mcous/rgb/README.md

# rgb
rgb led lighting. modules are (read: will be) daisy-chainable over cat5/6 cabling.

## status
### what works now
* the leds
* a few effects
  * cylon eye
  * new orleans superdome-syle rainbow flow
  * maybe some others

### what doesn't yet
* all other features

## firmware
### requirements
#### software (for mac, just download [CrossPack for AVR](http://www.obdev.at/products/crosspack/index.html))
* avrdude
* avr-objcopy
* avr-objdump
* avr-size
* avr-gcc

#### equipment
* some sort of avr isp

#### avr libraries
* [this tlc5940 avr library](http://github.com/mcous/TLC5940)

### setup instructions
1. clone the rgb repository to wherever you'd like
2. clone the TLC590 repository to the same place (i.e. one level above rgb/)
3. edit rgb/firmware/Makefile to use your isp (default is adafruit's [USBtinyISP](http://learn.adafruit.com/usbtinyisp))
  * depending on your isp, you may need to add `-P /whatever/your/port/is` after the isp name
  * per usual, [ladyada](http://www.ladyada.net/learn/avr/avrdude.html) can help

### flashing instructions (mac or linux)
1. plug in your isp and adjust makefile's portif necessary
2. navigate your terminal to rgb/firmware/
3. first time flashing:
  1. `$ make test` (ensures avr and isp are working)
  2. fix any connectivity problems; this will range from unplugging your isp and plugging it back in to re-soldering your mcu
  3. `$ make fuse` (writes correct fuse values to the avr)
  4. `$ make test` (ensure the new fuse values match the desired ones)
4. `$ make clean`
5. `$ make flash`

### instructions (windows)
1. google

## hardware
### requirements
* [KiCad eda software suite](http://kicad-pcb.org)
* [these KiCad libraries](http://github.com/mcous/kicad-lib)

### instructions
1. open kicad
2. open rgb-pcb.pro
3. ensure all component and footprint libraries from mcous/kicad-lib are installed
4. generate gerbers
5. order pcbs from your favorite manufacturer and parts from your favorite distributor
6. don't breathe the solder fumes
