mcous/rgb/pcb/rgb-pcb.sch

## KiCad design pcb/rgb-pcb.sch (2013-05-14)

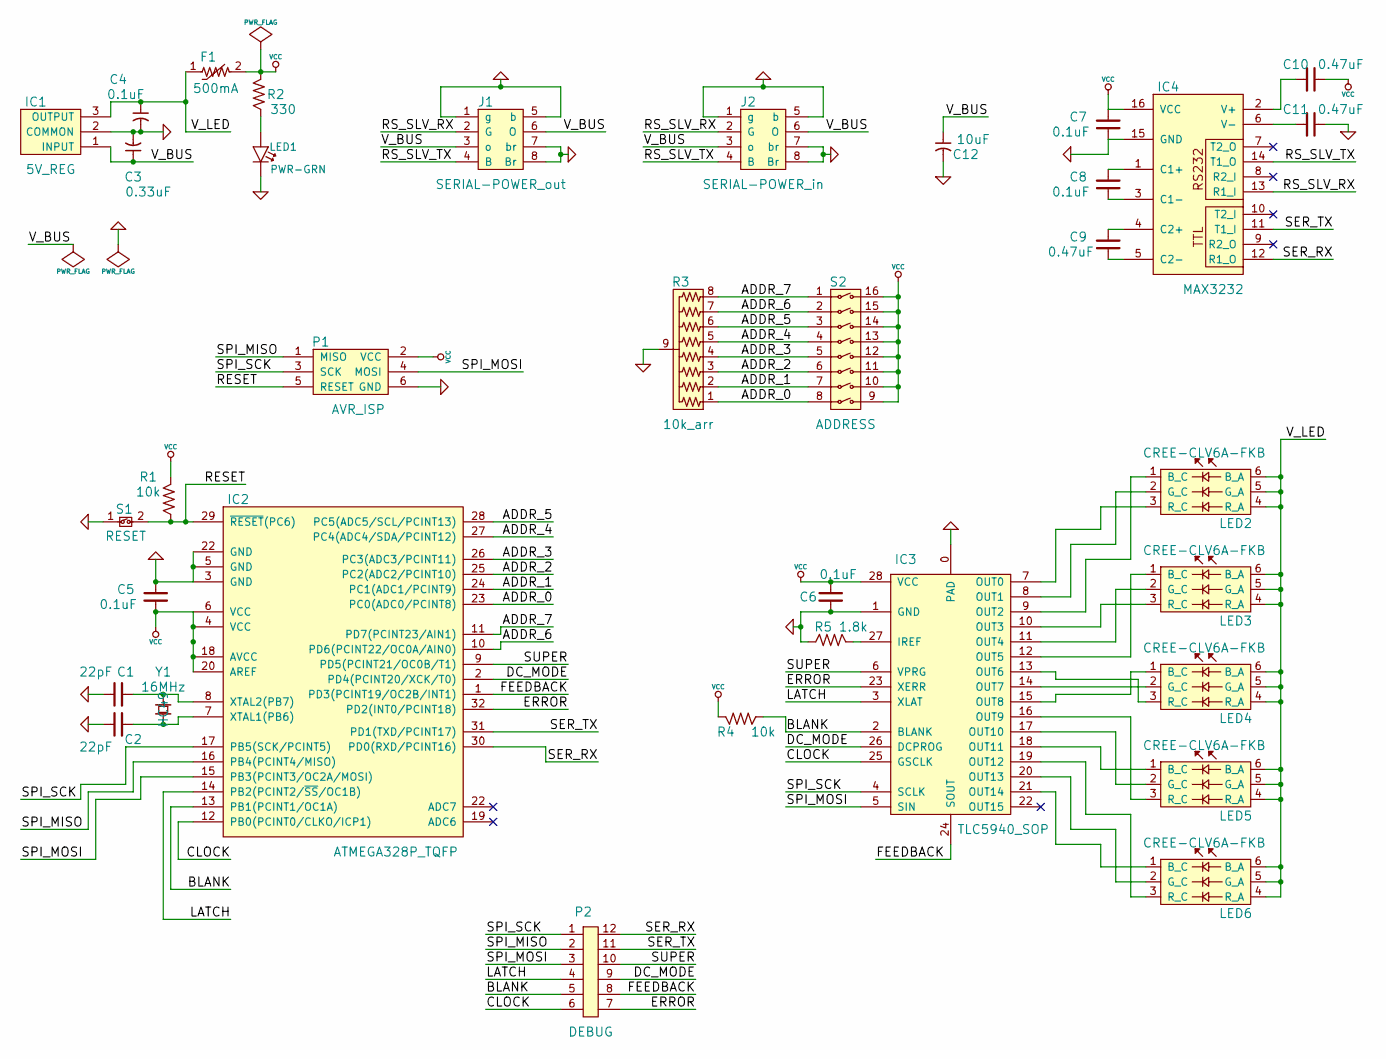
[picture p1: schematic rgb-pcb.sch]

Parts:
C1, C2: 22pF; 0603(1608m)
C3: 0.33uF; 0603(1608m)
C4, C5, C6, C7, C8: 0.1uF; 0603(1608m)
C9, C10, C11: 0.47uF; 0603(1608m)
C12: 10uF; 1206(3216m)
F1: 500mA; 1206(3216m)
IC1: 5V_REG; TO220_3pin
IC2: ATMEGA328P_TQFP; TQFP32_7mm
IC3: TLC5940_SOP; HTSSOP28
IC4: MAX3232; TSSOP16
J1: SERIAL-POWER_out; 8P8C_thru
J2: SERIAL-POWER_in; 8P8C_thru
LED1: PWR-GRN; 0603(1608m)
LED2, LED3, LED4, LED5, LED6: CREE-CLV6A-FKB; PLCC6
P1: AVR_ISP; 2x3-array
P2: DEBUG; SIP12
R1, R4: 10k; 0603(1608m)
R2: 330; 0603(1608m)
R3: 10k_arr; SIP9
R5: 1.8k; 0603(1608m)
S1: RESET; SPST_4-pin-thru
S2: ADDRESS; DIP16
Y1: 16MHz; HC49

Connections:
ADDR_0: IC2.23 (PC0(ADC0/PCINT8)), R3.1 (R1), S2.8
ADDR_1: IC2.24 (PC1(ADC1/PCINT9)), R3.2 (R2), S2.7
ADDR_2: IC2.25 (PC2(ADC2/PCINT10)), R3.3 (R3), S2.6
ADDR_3: IC2.26 (PC3(ADC3/PCINT11)), R3.4 (R4), S2.5
ADDR_4: IC2.27 (PC4(ADC4/SDA/PCINT12)), R3.5 (R5), S2.4
ADDR_5: IC2.28 (PC5(ADC5/SCL/PCINT13)), R3.6 (R6), S2.3
ADDR_6: IC2.10 (PD6(PCINT22/OC0A/AIN0)), R3.7 (R7), S2.2
ADDR_7: IC2.11 (PD7(PCINT23/AIN1)), R3.8 (R8), S2.1
BLANK: IC2.13 (PB1(PCINT1/OC1A)), IC3.2 (BLANK), P2.5, R4.1
CLOCK: IC2.12 (PB0(PCINT0/CLKO/ICP1)), IC3.25 (GSCLK), P2.6
DC_MODE: IC2.2 (PD4(PCINT20/XCK/T0)), IC3.26 (DCPROG), P2.9
ERROR: IC2.32 (PD2(INT0/PCINT18)), IC3.23 (XERR), P2.7
FEEDBACK: IC2.1 (PD3(PCINT19/OC2B/INT1)), IC3.24 (SOUT), P2.8
GND: C1.1, C2.1, C3.2, C4.2, C5.2, C6.2, C7.1, C11.2, C12.2, IC1.2 (COMMON), IC2.3 (GND), IC2.5 (GND), IC2.22 (ADC7), IC3.0 (PAD), IC3.1 (GND), IC4.15 (GND), J1.1 (g), J1.5 (b), J1.7 (br), J1.8 (Br), J2.1 (g), J2.5 (b), J2.7 (br), J2.8 (Br), LED1.2 (K), P1.6 (GND), R3.9 (COMMON), R5.1, S1.1
LATCH: IC2.14 (PB2(PCINT2/~SS~/OC1B)), IC3.3 (XLAT), P2.4
unnamed: C1.2, IC2.8 (XTAL2(PB7)), Y1.1
unnamed: C2.2, IC2.7 (XTAL1(PB6)), Y1.2
unnamed: C8.1, IC4.3 (C1-)
unnamed: C8.2, IC4.1 (C1+)
unnamed: C9.1, IC4.4 (C2+)
unnamed: C9.2, IC4.5 (C2-)
unnamed: C10.1, IC4.2 (V+)
unnamed: C11.1, IC4.6 (V-)
unnamed: IC3.7 (OUT0), LED2.3 (R_C)
unnamed: IC3.8 (OUT1), LED2.2 (G_C)
unnamed: IC3.9 (OUT2), LED2.1 (B_C)
unnamed: IC3.10 (OUT3), LED3.3 (R_C)
unnamed: IC3.11 (OUT4), LED3.2 (G_C)
unnamed: IC3.12 (OUT5), LED3.1 (B_C)
unnamed: IC3.13 (OUT6), LED4.3 (R_C)
unnamed: IC3.14 (OUT7), LED4.2 (G_C)
unnamed: IC3.15 (OUT8), LED4.1 (B_C)
unnamed: IC3.16 (OUT9), LED5.3 (R_C)
unnamed: IC3.17 (OUT10), LED5.2 (G_C)
unnamed: IC3.18 (OUT11), LED5.1 (B_C)
unnamed: IC3.19 (OUT12), LED6.3 (R_C)
unnamed: IC3.20 (OUT13), LED6.2 (G_C)
unnamed: IC3.21 (OUT14), LED6.1 (B_C)
unnamed: IC3.27 (IREF), R5.2
unnamed: LED1.1 (A), R2.1
RESET: IC2.29 (~RESET~(PC6)), P1.5 (RESET), R1.1, S1.2
RS_SLV_RX: IC4.13 (R1_I), J1.2 (G), J2.2 (G)
RS_SLV_TX: IC4.14 (T1_O), J1.4 (B), J2.4 (B)
SER_RX: IC2.30 (PD0(RXD/PCINT16)), IC4.12 (R1_O), P2.12
SER_TX: IC2.31 (PD1(TXD/PCINT17)), IC4.11 (T1_I), P2.11
SPI_MISO: IC2.16 (PB4(PCINT4/MISO)), P1.1 (MISO), P2.2
SPI_MOSI: IC2.15 (PB3(PCINT3/OC2A/MOSI)), IC3.5 (SIN), P1.4 (MOSI), P2.3
SPI_SCK: IC2.17 (PB5(SCK/PCINT5)), IC3.4 (SCLK), P1.3 (SCK), P2.1
SUPER: IC2.9 (PD5(PCINT21/OC0B/T1)), IC3.6 (VPRG), P2.10
VCC: C5.1, C6.1, C7.2, C10.2, F1.2, IC2.4 (VCC), IC2.6 (VCC), IC2.18 (AVCC), IC2.20 (AREF), IC3.28 (VCC), IC4.16 (VCC), P1.2 (VCC), R1.2, R2.2, R4.2, S2.9, S2.10, S2.11, S2.12, S2.13, S2.14, S2.15, S2.16
V_BUS: C3.1, C12.1, IC1.1 (INPUT), J1.3 (o), J1.6 (O), J2.3 (o), J2.6 (O)
V_LED: C4.1, F1.1, IC1.3 (OUTPUT), LED2.4 (R_A), LED2.5 (G_A), LED2.6 (B_A), LED3.4 (R_A), LED3.5 (G_A), LED3.6 (B_A), LED4.4 (R_A), LED4.5 (G_A), LED4.6 (B_A), LED5.4 (R_A), LED5.5 (G_A), LED5.6 (B_A), LED6.4 (R_A), LED6.5 (G_A), LED6.6 (B_A)
