mcous/rgb/(threads)

Thread 1 (2013-05-15):

linear voltage regulator is inefficient

mcous, 2013-05-15:
Daisy chain configuration will not work with a linear voltage regulator; the heat and current would not be good. The circuit should be upgraded to use a switching regulator.

mcous, 2021-04-23:
Archiving repository

Closed 2021-04-23.
