mcous/rgb/(commit log)

2013-05-01 Added several components to the library and started the schematic
    [pcb-proj.sch]
2013-05-01 Added gitignore for KiCAD files and continued library and schematic work
    [pcb-proj.sch]
2013-05-02 TLC5940 now in library and schematic
    [pcb-proj.sch, rgb-pcb.sch]
2013-05-02 Continued schematic work
    [rgb-pcb.sch]
2013-05-04 Removed component library in favor of library at mcous/kicad-lib
    [rgb-pcb.sch]
2013-05-04 Added RS232 to schematic
    [rgb-pcb.sch]
2013-05-04 Initial schematic seems finished. Might need to add some debugging pins
    [rgb-pcb.sch]
2013-05-05 Added that debugging header and improved the power circuits
    [rgb-pcb.sch]
2013-05-05 Moving on to component package selection
    [rgb-pcb.sch]
2013-05-06 Started mapping components to footprints
    [rgb-pcb.brd, rgb-pcb.sch]
2013-05-08 Continued footprint association. Also updated the gitignore for some temp files
    [rgb-pcb.sch]
2013-05-08 End of day commit
    [rgb-pcb.sch]
2013-05-08 Component to footprint selection done, moving to PCB layout
2013-05-09 Fixed up LED wiring and placed a majority of components. Board outline pretty set, running traces now
    [rgb-pcb.brd, rgb-pcb.sch]
2013-05-10 Continued board work and updated gitignore
    [rgb-pcb.brd, rgb-pcb.sch]
2013-05-10 Commiting before trying something else on a new branch
    [rgb-pcb.sch]
2013-05-10 Trying new board layout
    [rgb-pcb.brd]
2013-05-10 In progress commit
    [rgb-pcb.brd]
2013-05-10 Error checker is given erroneous output; board is layed out. Still need to put mounting slots in though
    [rgb-pcb.brd, rgb-pcb.sch]
2013-05-10 Board completely layed out. Time for DFM checks
    [rgb-pcb.brd]
2013-05-10 Added initial gerber plots
    [rgb-pcb-B_Mask.gbs, rgb-pcb-B_SilkS.gbo, rgb-pcb-Back.gbl, rgb-pcb-Edge_Cuts.gbr, rgb-pcb-F_Mask.gts, rgb-pcb-F_SilkS.gto, rgb-pcb-Front.gtl, rgb-pcb.drl]
2013-05-10 Subtracted soldermask from silkscreen
    [rgb-pcb.brd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]
2013-05-10 Trying a different silkscreen output
    [rgb-pcb-B_Mask.gbs, rgb-pcb-B_SilkS.gbo, rgb-pcb-Back.gbl, rgb-pcb-Edge_Cuts.gbr, rgb-pcb-F_Mask.gts, rgb-pcb-F_SilkS.gto, rgb-pcb-Front.gtl]
2013-05-10 Still dialing in gerber output settings
    [rgb-pcb-B_Mask.gbs, rgb-pcb-B_SilkS.gbo, rgb-pcb-Back.gbl, rgb-pcb-Edge_Cuts.gbr, rgb-pcb-F_Mask.gts, rgb-pcb-F_SilkS.gto, rgb-pcb-Front.gtl, rgb-pcb.drl]
2013-05-14 Reworked silkscreen and replotted gerbers
    [rgb-pcb.brd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]
2013-05-14 Added extra ground track for safety and changed drill file format for OSHPark
    [rgb-pcb.brd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]
2013-05-14 Added BOM
    [rgb-pcb-bom.csv, rgb-pcb.sch]
2013-05-14 Back annotated schematic with footprints
    [rgb-pcb.brd, rgb-pcb.sch]
2013-06-04 Wrote Makefile and added main program frame
2013-06-04 Added fuse values to Makefile
2013-06-05 Added framework for greyscale manipulation
2013-06-05 TLC5940 library finished (pre-bug-checking) following programming flowchart
2013-06-05 Added public function to set the led brightness
2013-06-05 Code compiles but does not appear to do anything on the board
2013-06-06 Major fixes. rgb board actually does something now
2013-06-13 only multiple driver error left
